ARTS-Laboratory/SEC-DAQ/versions/v0.9.2/BOM-v0.9.2.xlsx

Internal Part Name | Componet Class | MFR / Vendor Description | MFR Part Number | Primary vs Alternative | Quantity per board | Individual Cost | Total Cost | Notes | Vendor 1 | Vendor 2 | Vendor 3 | Vendor 4
CABLE TRIAXIAL RG-174 | Cable equipment | HUBER+SUHNER | G_02332 | Primary | 1 | $11.82 | $11.82 | 3m continuous; cut into 2 × 1.5 m lengths | https://www.digikey.com/en/products/detail/huber-suhner-inc/G-02332/16806917
DB9 METAL BACKSHELL | Cable equipment | Amphenol ICC (FCI) | 8655MH0901BLF | Primary | 1 | $6.47 | $6.47 | order qty as needed; Two-piece backshell; includes assembly hardware, grommets & 4-40 mating screws | https://www.digikey.com/en/products/detail/amphenol-cs-fci/8655MH0901BLF/1851324
DB9 MALE CONNECTOR | Cable equipment | NorComp Inc | 171-009-103L001 | Primary | 1 | $1.29 | $1.29 | order qty as needed; 9-pin male D-sub connector | https://www.digikey.com/en/products/detail/norcomp-inc/171-009-103L001/858099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
J-B WELD ORIGINAL EPOXY | Cable equipment | J-B Weld | 8265-S | Primary | 1 | $9.64 | $9.64 | Original Cold-Weld; steel-reinforced, 2-part epoxy | https://www.grainger.com/product/J-B-WELD-Epoxy-Adhesive-Professional-2UV83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
9-pin d'sub female | PCB Parts | CONN D-SUB RCPT 9P SMD R/A SLDR | L17SM209SB14T | Primary | 1 | $9.71 | $9.71 | 1 needed per PCB | https://www.digikey.com/en/products/detail/amphenol-cs-commercial-products/L17SM209SB14T/3464955
CDC | PCB Parts | IC CAPACITIVE SENSING 4CH 10VSSO | FDC1004QDGSRQ1 | Primary | 1 | $5.26 | $5.26 | 1 needed per PCB | https://www.digikey.com/en/products/detail/texas-instruments/FDC1004QDGSRQ1/5343524
Female socket header | PCB Parts | CONN RCPT 15POS 0.1 TIN PCB | SSW-115-01-T-S | Primary | 2 | $1.93 | $3.86 | 2 needed per PCB | https://www.digikey.com/en/products/detail/samtec-inc/SSW-115-01-T-S/1112290
2-pin connector | PCB Parts | CONN HEADER VERT 2POS 2.54MM | M20-9990246 | Primary | 1 | $0.10 | $0.10 | 1 needed per PCB | https://www.digikey.com/en/products/detail/harwin-inc/M20-9990246/3728226
DIP 1 pos switch | PCB Parts | SWITCH SLIDE DIP SPST 0.025A 24V | A6TN-1104 | Primary | 2 | $1.23 | $2.46 | 2 needed per PCB | https://www.digikey.com/en/products/detail/aratas-formerly-omron-components/A6TN-1104/2754763
DIP 2 pos switch | PCB Parts | SWITCH DIP SLIDE SPST 25MA 24V | A6TN-2104 | Primary | 3 | $1.64 | $4.92 | 3 needed per PCB | https://www.digikey.com/en/products/detail/aratas-formerly-omron-components/A6TN-2104/2627369
Optocoupler | PCB Parts | OPTOISO 3.75KV 1CH TRANS 4-SSOP | EL3H7(TA)-VG | Primary | 1 | $0.56 | $0.56 | 1 needed per PCB | https://www.digikey.com/en/products/detail/everlight-electronics-co-ltd/EL3H7-TA-VG/2675689
0.1 uF | Capacitors | CAP CER 0.1UF 50V X7R 0805 | C0805C104K5RACTU | Primary | 3 | $0.18 | $0.54 | 2 needed per PCB | https://www.digikey.com/en/products/detail/kemet/C0805C104K5RACTU/411169
1 uF | Capacitors | CAP CER 1UF 25V X7R 0805 | C2012X7R1E105K125AB | Primary | 3 | $0.23 | $0.69 | 2 needed per PCB | https://www.digikey.com/en/products/detail/tdk/C2012X7R1E105K125AB/513887
10 uF | Capacitors | CAP CER 10UF 10V X5R 0805 | C0805C106K8PAC7210 | Primary | 1 | $0.20 | $0.20 | 1 needed per PCB | https://www.digikey.com/en/products/detail/kemet/C0805C106K8PAC7210/12701235
51 pF | Capacitors | CAP CER 51PF 50V C0G/NP0 0805 | C0805C510J5GACTU | Primary | 1 | $0.37 | $0.37 | 1 needed per PCB | https://www.digikey.com/en/products/detail/kemet/C0805C510J5GACTU/2212930
100 uF | Capacitors | CAP CER 100UF 6.3V X5R 1206 | C3216X5R0J107M160AB | Primary | 1 | $1.05 | $1.05 | 1 needed per PCB | https://www.digikey.com/en/products/detail/tdk/C3216X5R0J107M160AB/2443486
0k1 | Resistors | RES 100 OHM 1% 1/4W 1206 | RC1206FR-07100RL | Primary | 1 | $0.11 | $0.11 | 1 needed per PCB | https://www.digikey.com/en/products/detail/yageo/RC1206FR-07100RL/728491
10k | Resistors | RES 10K OHM 1% 1/4W 1206 | RC1206FR-0710KL | Primary | 7 | $0.11 | $0.77 | 7 needed per PCB | https://www.digikey.com/en/products/detail/yageo/RC1206FR-0710KL/728483
4k7 | Resistors | RES 4.7K OHM 1% 1/4W 1206 | RC1206FR-074K7L | Primary | 2 | $0.11 | $0.22 | 2 needed per PCB | https://www.digikey.com/en/products/detail/yageo/RC1206FR-074K7L/728887
1 uH | Inductor | FIXED IND 1UH 1A 208 MOHM SMD | MLP2012S1R0MT0S1 | Primary | 1 | $0.24 | $0.24 | 1 needed per PCB | https://www.digikey.com/en/products/detail/tdk/MLP2012S1R0MT0S1/2465121
Arduino Nano V3.0 — ATmega328P | Arduino | ARDUINO NANO ATMEGA328 EVAL BRD | A000005 | Primary | 1 | $25.70 | $25.70 | 1 needed per PCB | https://www.digikey.com/en/products/detail/arduino/A000005/2638989
