ARTS-Laboratory/SEC-DAQ/versions/v0.9.2/hardware/KiCad_files/PCB layout/Shield_v0.9.2.kicad_pcb

## KiCad design versions/v0.9.2/hardware/KiCad_files/PCB layout/Shield_v0.9.2.kicad_pcb (2026-09-09)

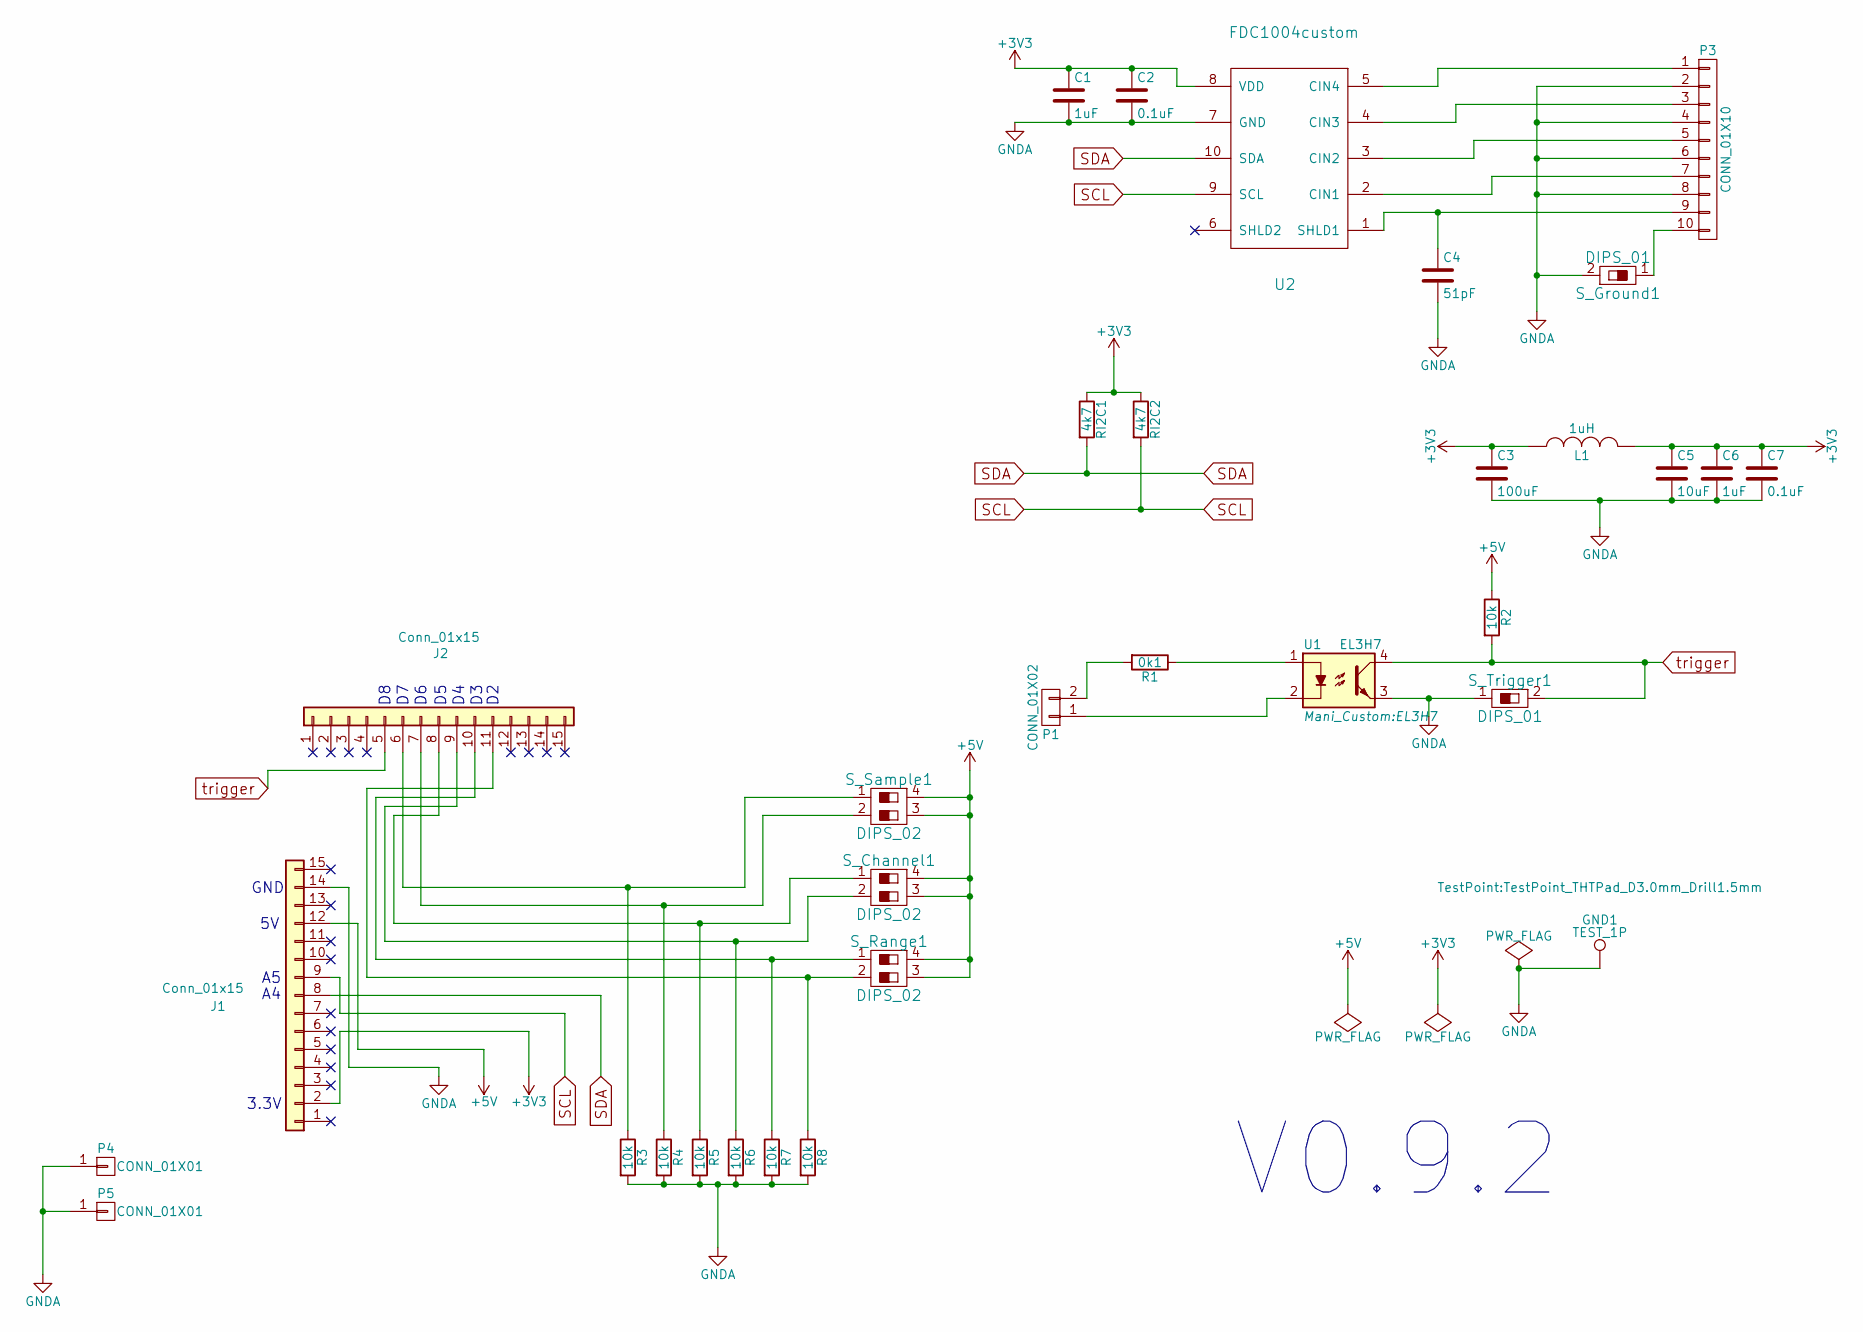
[picture p1: schematic Shield_v0.9.2.kicad_sch, Updated DAQ]

Parts:
C1, C6: 1uF; C_0805_2012Metric_Pad1.18x1.45mm_HandSolder
C2, C7: 0.1uF; C_0805_2012Metric_Pad1.18x1.45mm_HandSolder
C3: 100uF; C_1206_3216Metric_Pad1.33x1.80mm_HandSolder
C4: 51pF; C_0805_2012Metric_Pad1.18x1.45mm_HandSolder
C5: 10uF; C_0805_2012Metric_Pad1.18x1.45mm_HandSolder
GND1: TEST_1P; TestPoint_THTPad_D3.0mm_Drill1.5mm
J1, J2: Conn_01x15; PinSocket_1x15_P2.54mm_Vertical
L1: 1uH; R_0805_2012Metric_Pad1.20x1.40mm_HandSolder
P1: CONN_01X02; PinHeader_1x02_P2.54mm_Vertical
P3: CONN_01X10; DSUB-9_surface_mount
P4, P5: CONN_01X01; GNDA_Pad_4.064mm
R1: 0k1; R_1206_3216Metric_Pad1.30x1.75mm_HandSolder
R2, R3, R4, R5, R6, R7, R8: 10k; R_1206_3216Metric_Pad1.30x1.75mm_HandSolder
RI2C1, RI2C2: 4k7; R_1206_3216Metric_Pad1.30x1.75mm_HandSolder
S_Channel1: DIPS_02; SW_DIP_SPSTx02_Slide_9.78x7.26mm_W7.62mm_P2.54mm
S_Ground1: DIPS_01; SW_DIP_SPSTx01_Slide_9.78x4.72mm_W7.62mm_P2.54mm
S_Range1: DIPS_02; SW_DIP_SPSTx02_Slide_9.78x7.26mm_W7.62mm_P2.54mm
S_Sample1: DIPS_02; SW_DIP_SPSTx02_Slide_9.78x7.26mm_W7.62mm_P2.54mm
S_Trigger1: DIPS_01; SW_DIP_SPSTx01_Slide_9.78x4.72mm_W7.62mm_P2.54mm
U1: EL3H7
U2: FDC1004custom; SOIC_10_FDC1004

Connections:
+3V3: C1.1, C2.1, C3.1, C5.1, C6.1, C7.1, J1.2, L1.1, L1.2, RI2C1.1, RI2C2.1, U2.8 (VDD)
+5V: J1.12, R2.1, S_Channel1.3, S_Channel1.4, S_Range1.3, S_Range1.4, S_Sample1.3, S_Sample1.4
GNDA: C1.2, C2.2, C3.2, C4.2, C5.2, C6.2, C7.2, GND1.1 (1_1), J1.14, P3.2, P3.4, P3.6, P3.8, P4.1 (P1_1), P5.1 (P1_1), R3.2, R4.2, R5.2, R6.2, R7.2, R8.2, S_Ground1.2, S_Trigger1.1, U1.3, U2.7 (GND)
unnamed: J2.6, R3.1, S_Sample1.1
unnamed: J2.7, R4.1, S_Sample1.2
unnamed: J2.8, R5.1, S_Channel1.1
unnamed: J2.9, R6.1, S_Channel1.2
unnamed: J2.10, R7.1, S_Range1.1
unnamed: J2.11, R8.1, S_Range1.2
unnamed: P1.1, U1.2
unnamed: P1.2, R1.2
unnamed: P3.1, U2.5 (CIN4)
unnamed: P3.3, U2.4 (CIN3)
unnamed: P3.5, U2.3 (CIN2)
unnamed: P3.7, U2.2 (CIN1)
unnamed: C4.1, P3.9, U2.1 (SHLD1)
unnamed: P3.10, S_Ground1.1
unnamed: R1.1, U1.1
SCL: J1.9, RI2C2.2, U2.9 (SCL)
SDA: J1.8, RI2C1.2, U2.10 (SDA)
trigger: J2.5, R2.2, S_Trigger1.2, U1.4

Notes on the sheet:
3.3V
V0.9.2
GND

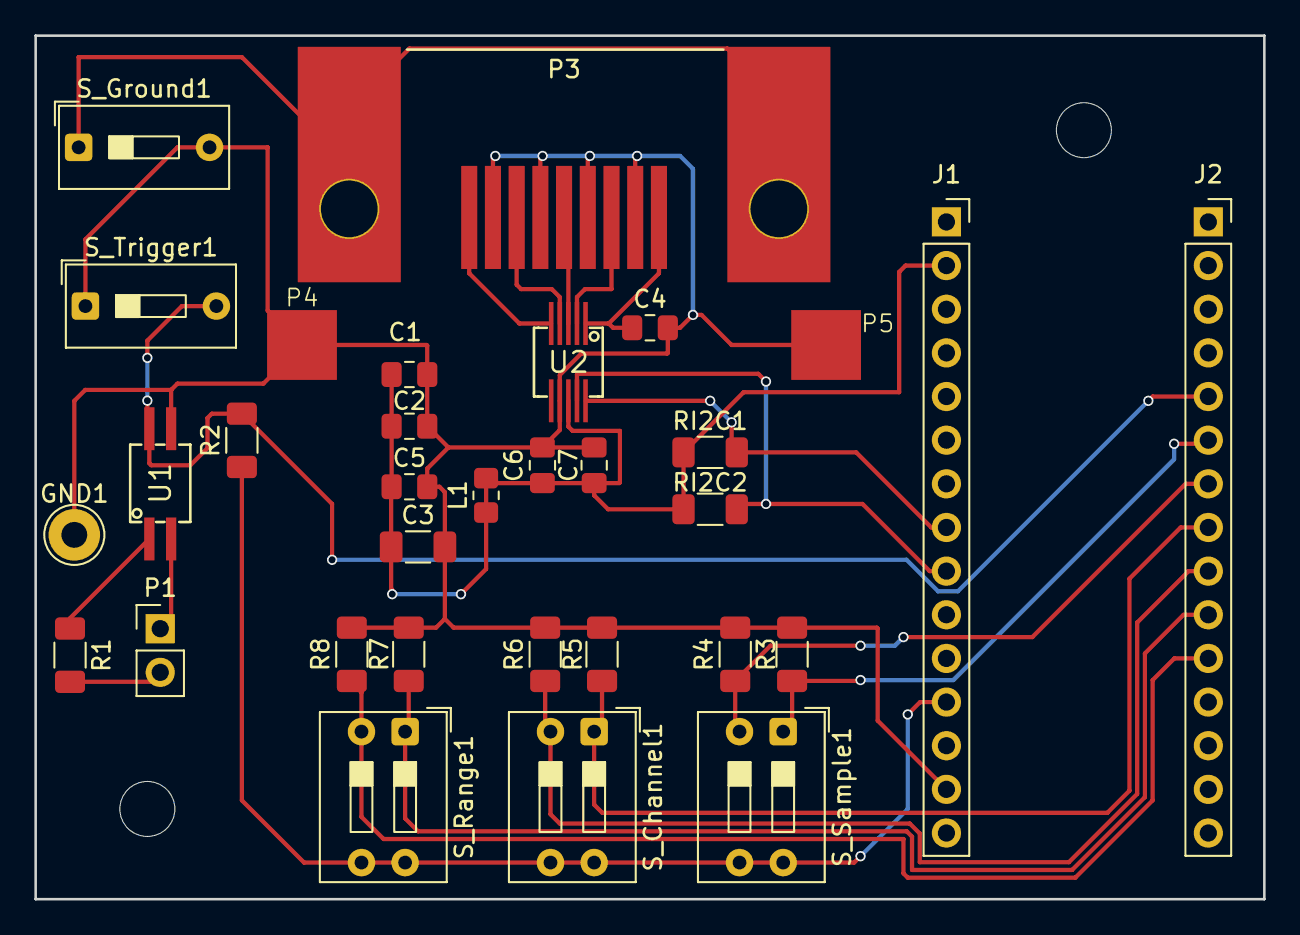
[picture p2: board Shield_v0.9.2.kicad_pcb from above]

Board: 2 copper layers, 71.5 x 50.2 mm, 32 parts (0 on the bottom side), 21 nets.
