ARTS-Laboratory/SEC-DAQ/(commit log)

2026-09-08 Updated DAQ
    [Shield_V0.3.kicad_pcb, Shield_V0.3.kicad_sch]
2026-09-08 Update DAQ
    [Shield_V0.3.kicad_pcb]
2026-09-09 Added Logos
    [Shield_v0.9.2.kicad_pcb, Shield_v0.9.2.kicad_sch]
2026-09-10 cleaned up the pcb file structure
    [Shield_v0.9.2.kicad_pcb, Shield_v0.9.2.kicad_sch, noname_shell.dsn, prototype.csv, prototype.dsn, prototype.kicad_pcb, prototype.kicad_sch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]
2026-09-10 Cleaned up v0.9.2
    [noname_shell.dsn, prototype.csv, prototype.dsn, prototype.kicad_pcb, prototype.kicad_sch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]
2026-11-10 Updated BOM
